ChristopherCa5/PWM-Speed-Controller/ece148_switch_opamp_chargepump.asc

A1: inv; Vhigh=5 Vlow=0 Trise=20n Tfall=20n Td=10n
A2: inv; Vhigh=5 td=10n trise=20n tfall=20n
A3: inv; Vhigh=5 Vlow=0 Trise=20n Tfall=20n Td=10n
C1: cap; 330n
C2: cap; 330n
C3: cap; 1n
C4: cap; 100n
C5: cap; 1n
C6: cap; 1n
C7: cap; 1µ
C8: cap; 10µ
D1: diode
D2: diode
M1: nmos; 2N7000KL
Q1: pnp; 2N3906
R1: res; 100k
R2: res; 200k
R3: res; 1Meg
R5: res; 10Meg
R6: res; 22k
R7: res; 4.23k
R8: res; 100k
R9: res; 100
R10: res; 5k
R11: res; 10k
U1: LM311
V1: voltage; 5
V2: voltage; PULSE(0 5 1n 1n 1n {dc} 20m)
V6: voltage; 5
Named nets: 0, Vin, Vout, Vfilter, vo, Vhi
.lib C:\\Users\\bubba\\Downloads\\LM741.txt
.tran 1
.step param dc 1m 2m .25m
.lib C:\\Users\\bubba\\Downloads\\2N7000KL.txt
