ChristopherCa5/PWM-Speed-Controller/(commit log)

2026-06-20 LTspice Circuit
2026-06-20 No PWM
2026-06-20 First circuit on breadboard
2026-06-20 First Breadboard Circuit (no pwm)
2026-06-20 PWM simulation
2026-06-20 Oscilloscope view of PWM output signal
2026-06-20 Final circuit
    i forgot to take a picture of it while it was mounted to the nerf gun.
2026-06-21 protoboard first circuit
